yorkyg/SICAVI---Proyecto-Final-UTESA/CSharp/SICAVI_Camara_STM32/PromptLog.md

# Registro de consultas y dudas técnicas

Completar durante el desarrollo con la fecha, la duda consultada, la respuesta útil y la modificación realizada manualmente.

| Fecha | Consulta o duda | Aplicación en el proyecto |
|---|---|---|
|  | ¿Cómo seleccionar una webcam por índice con OpenCvSharp en Windows Forms? |  |
|  | ¿Por qué el rojo necesita dos rangos en el canal H de HSV? |  |
|  | ¿Cómo evitar que la captura de video bloquee la interfaz? |  |
|  | ¿Cómo distinguir círculo, cuadrado y triángulo mediante contornos? |  |
|  | ¿Cómo se calcula la circularidad de un contorno? |  |
|  | ¿Qué recursos `Mat` deben liberarse con `Dispose` o `using`? |  |
|  | ¿Cómo validar una trama UART con Regex sin aceptar datos incompletos? |  |
| 2026-08-26 | ¿Cómo incorporar login, roles e historial industrial en SQL Server sin perder el diseñador visual de WinForms? | Se separaron los formularios en `.cs`, `.Designer.cs` y `.resx`; se agregó inicialización SQL, repositorios parametrizados, PBKDF2, usuarios, inspecciones, horómetro y alarmas. |
