yorkyg/SICAVI---Proyecto-Final-UTESA/docs/assets/vision-mascara-tarjeta.png

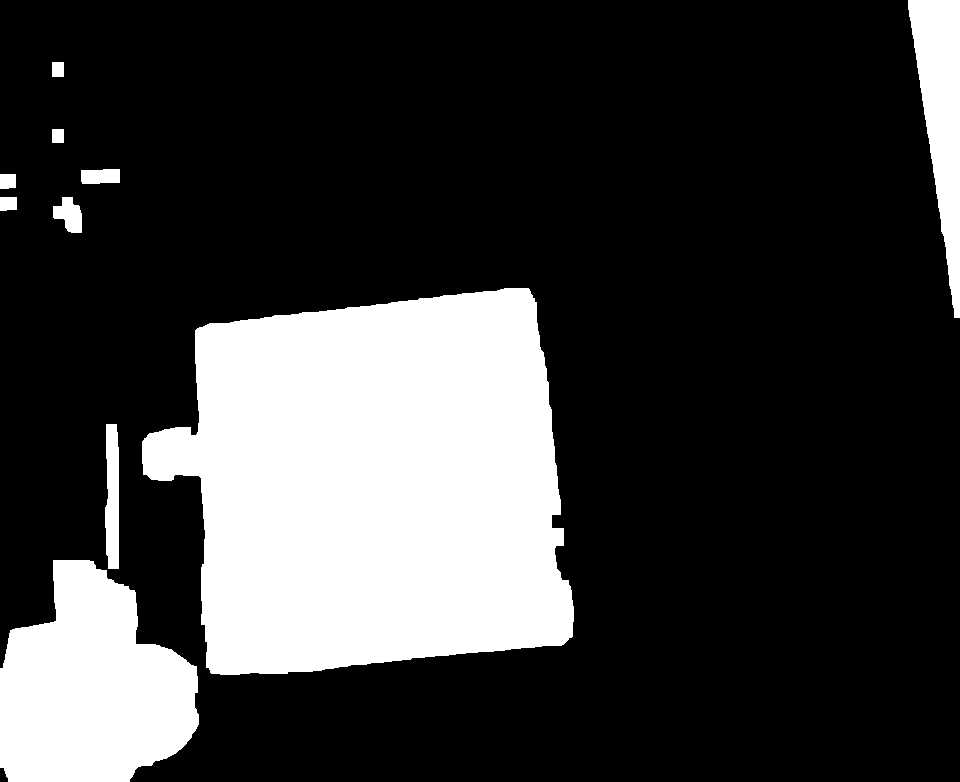
docs/assets/vision-mascara-tarjeta.png
