yorkyg/SICAVI---Proyecto-Final-UTESA/docs/assets/vision-mascara-y-contorno.png

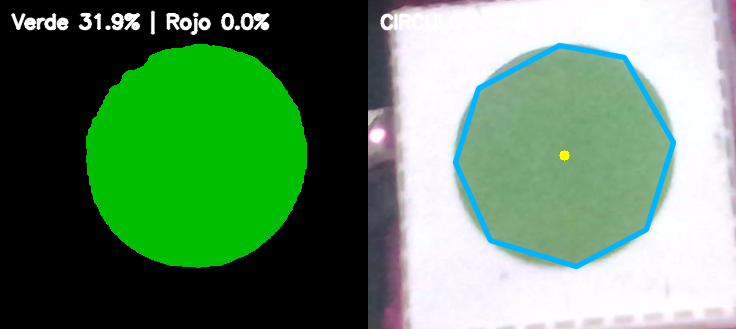
docs/assets/vision-mascara-y-contorno.png
