yorkyg/SICAVI---Proyecto-Final-UTESA/SICAVI_STM32_G071RB/Src/main.c

#include "main.h"
#include "protocolo_uart.h"
#include "sicavi_control.h"

TIM_HandleTypeDef htim6;
UART_HandleTypeDef huart2;

void SystemClock_Config(void);
static void MX_TIM6_Init(void);
static void MX_USART2_UART_Init(void);

int main(void)
{
    HAL_Init();
    SystemClock_Config();
    MX_TIM6_Init();
    MX_USART2_UART_Init();

    sicavi_inicializar(&huart2);

    if (HAL_TIM_Base_Start_IT(&htim6) != HAL_OK)
    {
        Error_Handler();
    }

    while (1)
    {
        sicavi_procesar();
    }
}

void SystemClock_Config(void)
{
    RCC_OscInitTypeDef RCC_OscInitStruct = {0};
    RCC_ClkInitTypeDef RCC_ClkInitStruct = {0};
    RCC_PeriphCLKInitTypeDef PeriphClkInit = {0};

    HAL_PWREx_ControlVoltageScaling(PWR_REGULATOR_VOLTAGE_SCALE1);

    RCC_OscInitStruct.OscillatorType = RCC_OSCILLATORTYPE_HSI;
    RCC_OscInitStruct.HSIState = RCC_HSI_ON;
    RCC_OscInitStruct.HSIDiv = RCC_HSI_DIV1;
    RCC_OscInitStruct.HSICalibrationValue = RCC_HSICALIBRATION_DEFAULT;
    RCC_OscInitStruct.PLL.PLLState = RCC_PLL_ON;
    RCC_OscInitStruct.PLL.PLLSource = RCC_PLLSOURCE_HSI;
    RCC_OscInitStruct.PLL.PLLM = RCC_PLLM_DIV1;
    RCC_OscInitStruct.PLL.PLLN = 8;
    RCC_OscInitStruct.PLL.PLLP = RCC_PLLP_DIV2;
    RCC_OscInitStruct.PLL.PLLQ = RCC_PLLQ_DIV2;
    RCC_OscInitStruct.PLL.PLLR = RCC_PLLR_DIV2;
    if (HAL_RCC_OscConfig(&RCC_OscInitStruct) != HAL_OK) Error_Handler();

    RCC_ClkInitStruct.ClockType = RCC_CLOCKTYPE_HCLK |
                                  RCC_CLOCKTYPE_SYSCLK |
                                  RCC_CLOCKTYPE_PCLK1;
    RCC_ClkInitStruct.SYSCLKSource = RCC_SYSCLKSOURCE_PLLCLK;
    RCC_ClkInitStruct.AHBCLKDivider = RCC_SYSCLK_DIV1;
    RCC_ClkInitStruct.APB1CLKDivider = RCC_HCLK_DIV1;
    if (HAL_RCC_ClockConfig(&RCC_ClkInitStruct, FLASH_LATENCY_2) != HAL_OK) Error_Handler();

    PeriphClkInit.PeriphClockSelection = RCC_PERIPHCLK_USART2;
    PeriphClkInit.Usart2ClockSelection = RCC_USART2CLKSOURCE_PCLK1;
    if (HAL_RCCEx_PeriphCLKConfig(&PeriphClkInit) != HAL_OK) Error_Handler();
}

static void MX_TIM6_Init(void)
{
    htim6.Instance = TIM6;
    htim6.Init.Prescaler = 63999U;
    htim6.Init.CounterMode = TIM_COUNTERMODE_UP;
    htim6.Init.Period = 9U;
    htim6.Init.AutoReloadPreload = TIM_AUTORELOAD_PRELOAD_DISABLE;
    if (HAL_TIM_Base_Init(&htim6) != HAL_OK) Error_Handler();
}

static void MX_USART2_UART_Init(void)
{
    huart2.Instance = USART2;
    huart2.Init.BaudRate = 115200;
    huart2.Init.WordLength = UART_WORDLENGTH_8B;
    huart2.Init.StopBits = UART_STOPBITS_1;
    huart2.Init.Parity = UART_PARITY_NONE;
    huart2.Init.Mode = UART_MODE_TX_RX;
    huart2.Init.HwFlowCtl = UART_HWCONTROL_NONE;
    huart2.Init.OverSampling = UART_OVERSAMPLING_16;
    huart2.Init.OneBitSampling = UART_ONE_BIT_SAMPLE_DISABLE;
    huart2.Init.ClockPrescaler = UART_PRESCALER_DIV1;
    huart2.AdvancedInit.AdvFeatureInit = UART_ADVFEATURE_NO_INIT;
    if (HAL_UART_Init(&huart2) != HAL_OK) Error_Handler();
    if (HAL_UARTEx_SetTxFifoThreshold(&huart2, UART_TXFIFO_THRESHOLD_1_8) != HAL_OK) Error_Handler();
    if (HAL_UARTEx_SetRxFifoThreshold(&huart2, UART_RXFIFO_THRESHOLD_1_8) != HAL_OK) Error_Handler();
    if (HAL_UARTEx_DisableFifoMode(&huart2) != HAL_OK) Error_Handler();
}

void HAL_TIM_PeriodElapsedCallback(TIM_HandleTypeDef *htim)
{
    if (htim->Instance == TIM6) sicavi_tick_10ms_isr();
}

void HAL_GPIO_EXTI_Rising_Callback(uint16_t GPIO_Pin)
{
    if (GPIO_Pin == GPIO_PIN_9) sicavi_sensor_caja_isr();
}

void HAL_GPIO_EXTI_Falling_Callback(uint16_t GPIO_Pin)
{
    if (GPIO_Pin == GPIO_PIN_9) sicavi_sensor_caja_isr();
}

void HAL_UART_RxCpltCallback(UART_HandleTypeDef *huart)
{
    protocolo_uart_rx_callback(huart);
}

void HAL_UART_ErrorCallback(UART_HandleTypeDef *huart)
{
    protocolo_uart_error_callback(huart);
}

void Error_Handler(void)
{
    __disable_irq();
    while (1) { }
}

#ifdef USE_FULL_ASSERT
void assert_failed(uint8_t *file, uint32_t line)
{
    (void)file;
    (void)line;
}
#endif
