yorkyg/SICAVI---Proyecto-Final-UTESA/SICAVI_STM32_G071RB/SICAVI_STM32_G071RB.ioc

Mcu.UserName=STM32G071RBTx
PA0.Signal=ADC1_IN0
PA13.Signal=SYS_SWDIO
PA14-BOOT0.Signal=SYS_SWCLK
PA2.GPIO_Label=USART2_TX_STLINK
PA2.Signal=USART2_TX
PA3.GPIO_Label=USART2_RX_STLINK
PA3.Signal=USART2_RX
PA5.GPIO_Label=LED_ACEPTADO_VERDE_D13_LD4
PA5.Signal=GPIO_Output
PA6.GPIO_Label=LED_RECHAZADO_ROJO_D12
PA6.Signal=GPIO_Output
PA7.GPIO_Label=LED_ESTADO_AMARILLO_D11
PA7.Signal=GPIO_Output
PA9.GPIO_Label=SENSOR_CAJA_D8
PA9.Signal=GPXTI9
PB1.GPIO_Label=RELE_EXPULSOR_A3
PB1.Signal=GPIO_Output
PC1.GPIO_Label=BOTON_STOP
PC1.Signal=GPIO_Input
PC13.GPIO_Label=BOTON_START_B1
PC13.Signal=GPIO_Input
PC7.GPIO_Label=DRIVER_MOTOR_EN1_D9
PC7.Signal=GPIO_Output
