yorkyg/SICAVI---Proyecto-Final-UTESA/(commit log)

2026-08-28 Entrega final SICAVI: STM32, C#, documentación y pruebas
2026-08-28 Corrige subtitulo del banner de SICAVI
